BadgePiratesLLC/DefCon_SecKCPartyStar_27/README.md

Party Star 'badge' for the DEFCON 27 SecKC Party.

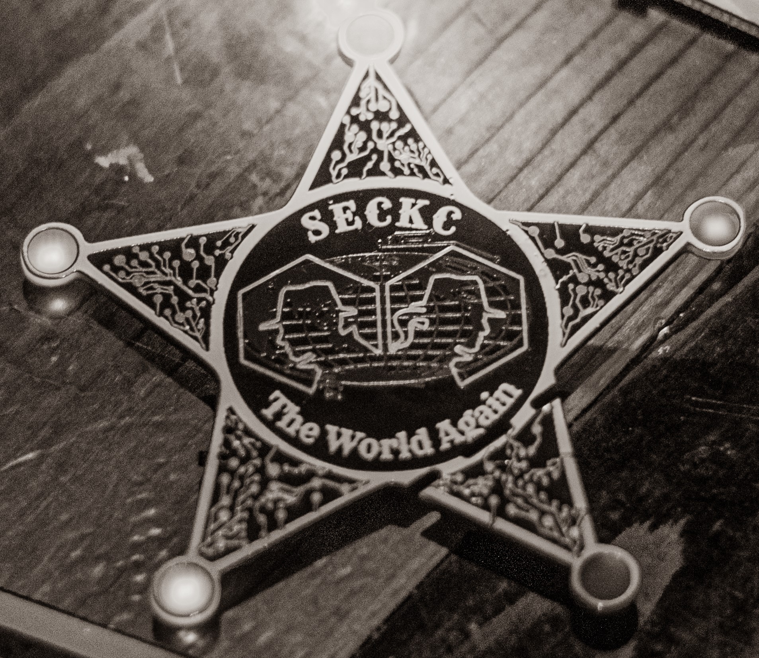
[picture p1: SAO_Twitter_Banner.jpg]
Image of Star
