BadgePiratesLLC/DefCon_SecKCPartyStar_27/Schematics/.svg2shenzhen-cache/images/B.Mask_g828.png

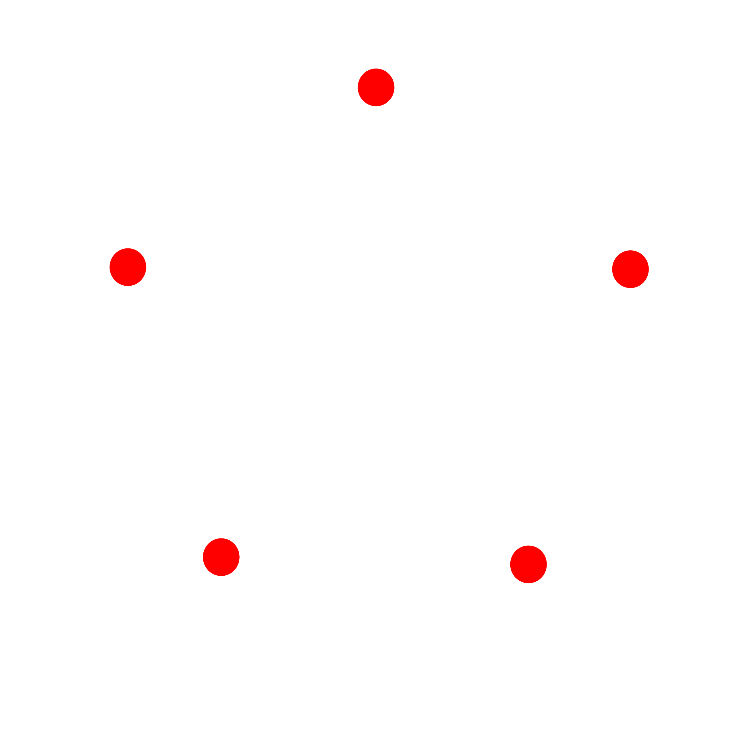
Schematics/.svg2shenzhen-cache/images/B.Mask_g828.png
