BadgePiratesLLC/DefCon_SecKCPartyStar_27/Schematics/.svg2shenzhen-cache/images/F.Cu_g832.png

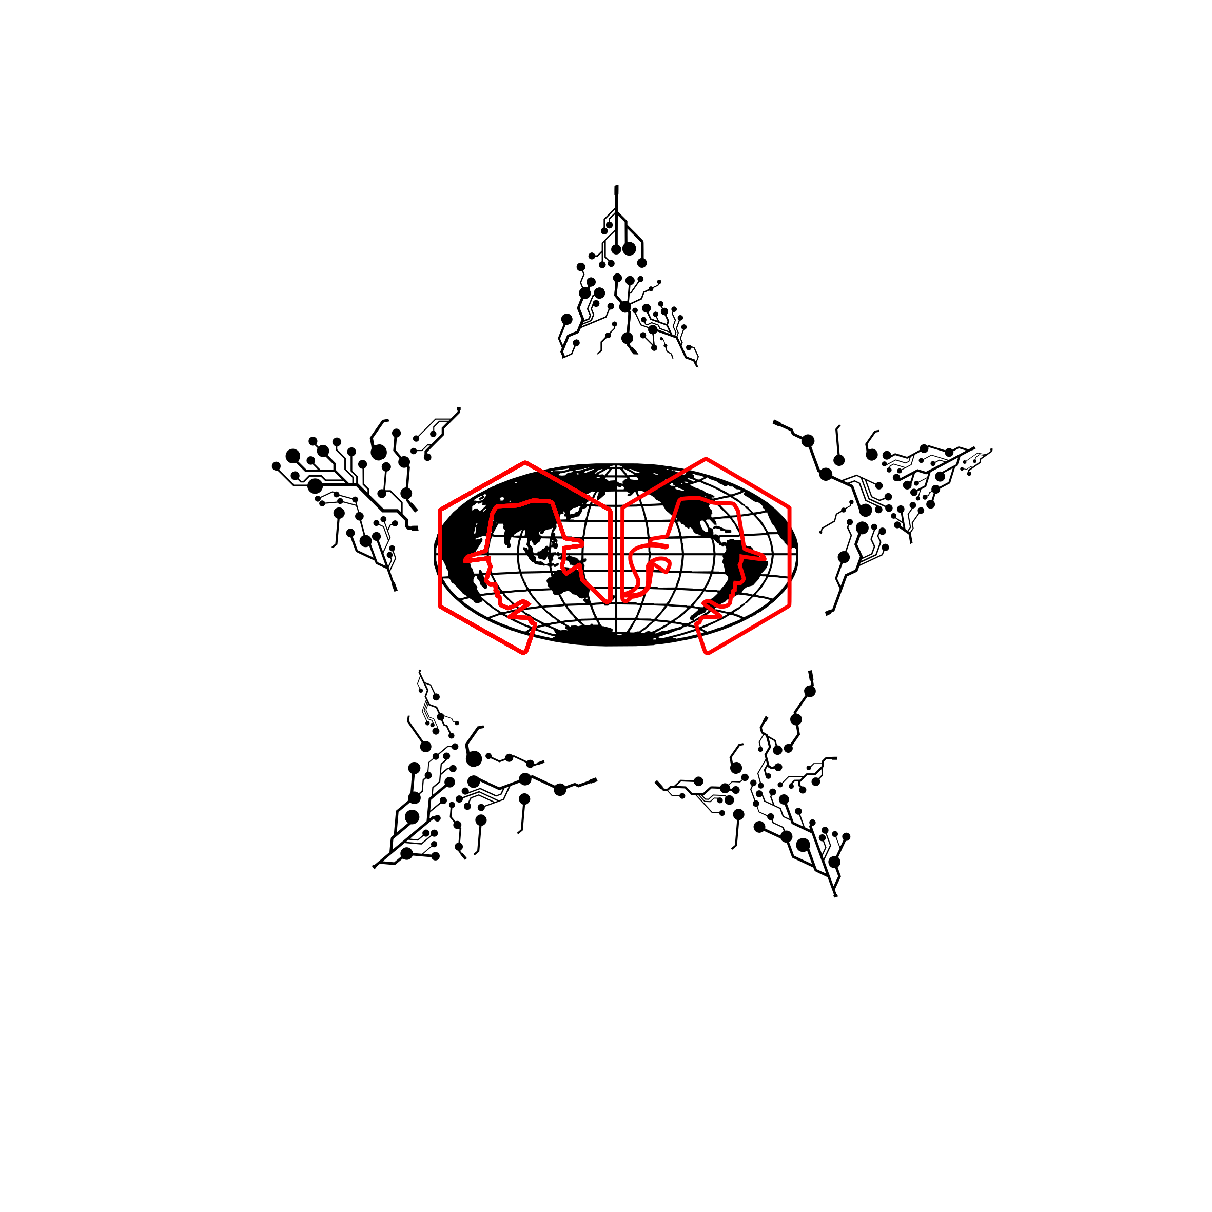
Schematics/.svg2shenzhen-cache/images/F.Cu_g832.png
