BadgePiratesLLC/DefCon_SecKCPartyStar_27/Schematics/.svg2shenzhen-cache/images/F.Mask_g834.png

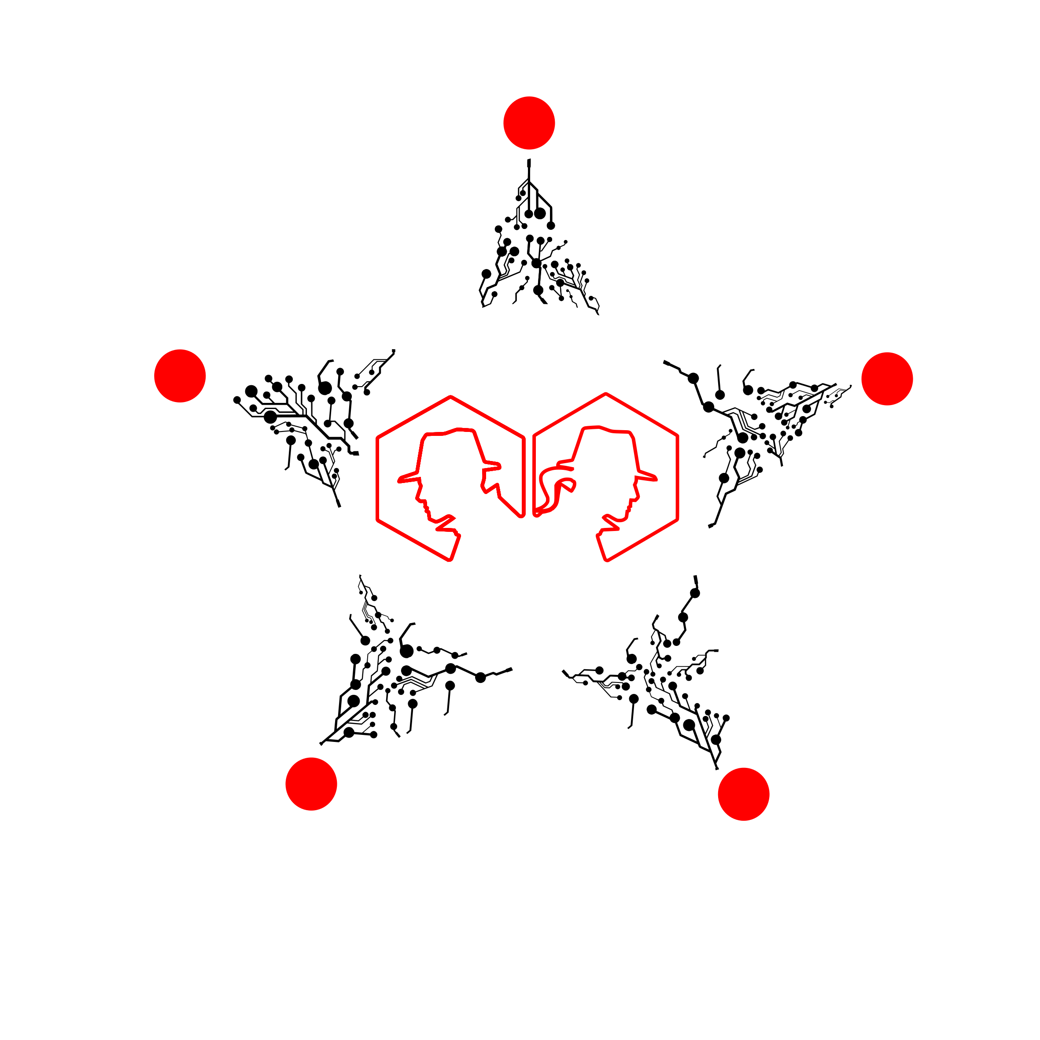
Schematics/.svg2shenzhen-cache/images/F.Mask_g834.png
