BadgePiratesLLC/DefCon_SecKCPartyStar_27/Schematics/.svg2shenzhen-cache/images/F.Silk_g836.png

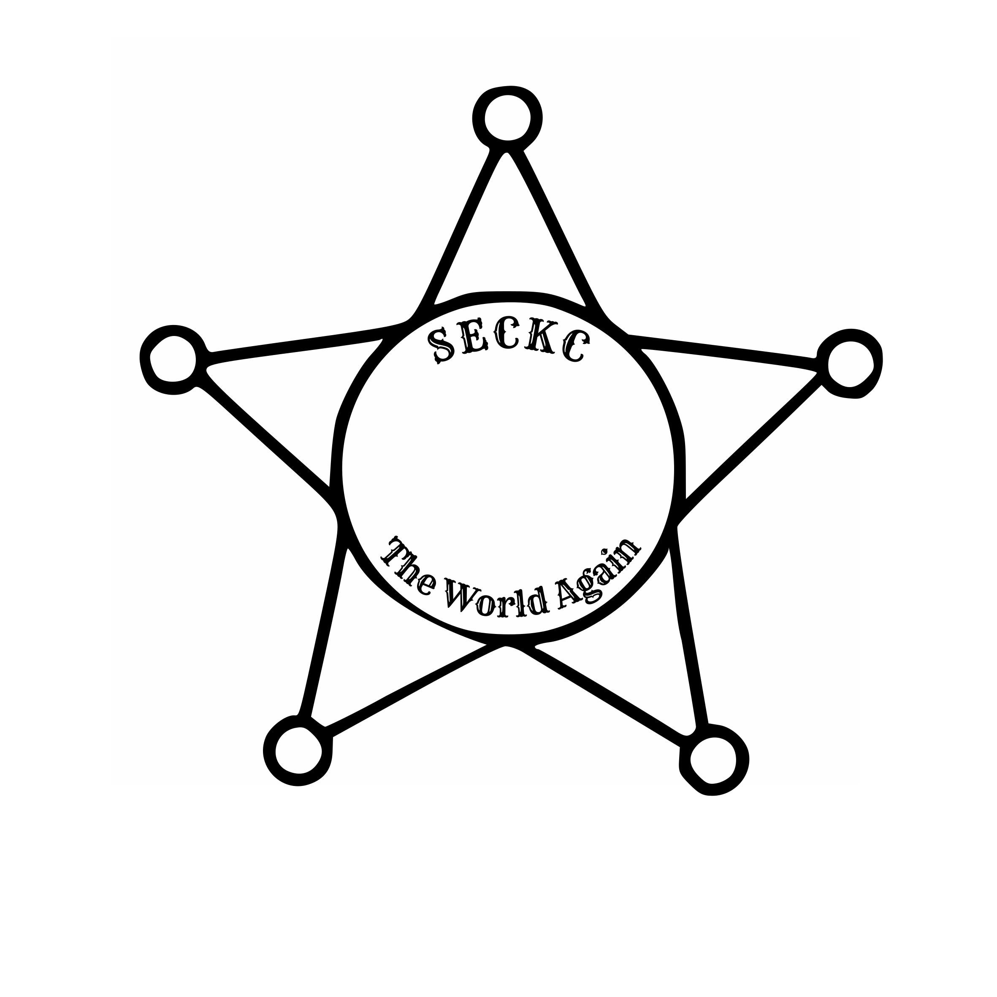
Schematics/.svg2shenzhen-cache/images/F.Silk_g836.png
