BadgePiratesLLC/DefCon_SecKCPartyStar_27/Schematics/PartyStar.xlsx

/home/william/Documents/Projects/BadgePirates/defcon27-seckc_party/Schematics/PartyStar.sch
Fri 28 Jun 2019 12:08:12 PM CDT
Eeschema 5.1.2
Component Count:19
Ref | Qnty | Value | Part | Datasheet | Description | Price each @ 100 |  | Source
BT1 | 1 | Battery_Cell | Device:Battery_Cell | ~ | Single-cell battery |  |  | Beats me
C1, C2 | 2 | 100uF | Device:CP_Small | ~ | Polarized capacitor, small symbol | 0.097 | 0.194 | https://lcsc.com/product-detail/Others_AVX_F930J107MAA_AVX-F930J107MAA_C90056.html
D1, D2, D3, D4 | 4 | LED | Device:LED | ~ | Light emitting diode | 0.0089 | 0.0356 | https://lcsc.com/product-detail/Light-Emitting-Diodes-LED_0805_C205444.html
J1 | 1 | Conn_02x03_Odd_Even | Connector_Generic:Conn_02x03_Odd_Even | ~ | Generic connector, double row, 02x03 | 0.0326 | 0.0326 | https://lcsc.com/product-detail/Pin-Header-Female-Header_Shenzhen-Cankemeng-Headers-Pins-2-3P-2-54mm-SMD_C124390.html
Q1, Q2 | 2 | Q_PNP_BCE | Device:Q_PNP_BCE | ~ | PNP transistor, base/collector/emitter | 0.0121 | 0.0242 | https://lcsc.com/product-detail/MOSFET_Guangdong-Hottech-2N7002_C181082.html
Q3 | 1 | 2N7002 | Transistor_FET:2N7002 | https://www.fairchildsemi.com/datasheets/2N/2N7002.pdf | 0.115A Id, 60V Vds, N-Channel MOSFET, SOT-23 | 0.0118 | 0.0118 | https://lcsc.com/product-detail/MOSFET_SK-2N7002-Silk-screen12W_C111581.html
R1, R2, R5 | 3 | 330 | Device:R_Small | ~ | Resistor, small symbol | 0.0012 | 0.0036 | https://lcsc.com/product-detail/Chip-Resistor-Surface-Mount_330R-331-5_C119075.html
R3, R4 | 2 | 100k | Device:R_Small | ~ | Resistor, small symbol | 0.0012 | 0.0024 | https://lcsc.com/product-detail/New-Arrivals_SANYEAR-SY0805JN100KP_C380778.html
SW1 | 1 | SW_SPDT | Switch:SW_SPDT | ~ | Switch, single pole double throw | 0.0429 | 0.0429 | https://lcsc.com/product-detail/Toggle-Switches_XKB-Enterprise-SK-3296S-01-L1_C319020.html
 |  |  |  |  |  | Total w/o battery | 0.3471
