BadgePiratesLLC/DefCon_SecKCPartyStar_27/(commit log)

2019-06-26 think i got everything working
    [defcon27-seckc-party.kicad_pcb, defcon27-seckc-party.sch]
2019-06-27 final design
    [defcon27-seckc-party.kicad_pcb]
2019-06-27 updated font to Rye and made fonts smaller for both texts
    [defcon27-seckc-party.kicad_pcb]
2019-06-28 Added breakable point
    [PartyStar.kicad_pcb]
2019-06-28 cleaned up the fake traces
    [PartyStar.kicad_pcb]
2019-06-28 added back of board stuff
    [PartyStar.kicad_pcb]
2019-06-28 Ordered V1
    [PartyStar-B_Cu.gbr, PartyStar-B_Mask.gbr, PartyStar-B_SilkS.gbr, PartyStar-Edge_Cuts.gbr, PartyStar-F_Cu.gbr, PartyStar-F_Mask.gbr, PartyStar-F_SilkS.gbr, PartyStar-NPTH.drl]
2019-06-28 Cleaned up traces
    [PartyStar.kicad_pcb]
2019-06-28 More fiddling 2: electric boogaloo
    [PartyStar-B_Cu.gbr, PartyStar-B_Mask.gbr, PartyStar-B_SilkS.gbr, PartyStar-Edge_Cuts.gbr, PartyStar-F_Cu.gbr, PartyStar-F_Mask.gbr, PartyStar-F_SilkS.gbr, PartyStar-NPTH.drl]
2019-06-28 Added bom
    [PartyStar.xlsx]
2019-06-30 fix back solder mask
    [PartyStar.kicad_pcb]
2019-06-30 Fixed SAO header
    [PartyStar.kicad_pcb]
2019-07-04 Added DCP logo
    [PartyStar-B_Cu.gbr, PartyStar-B_Mask.gbr, PartyStar-B_SilkS.gbr, PartyStar-Edge_Cuts.gbr, PartyStar-F_Cu.gbr, PartyStar-F_Mask.gbr, PartyStar-F_SilkS.gbr, PartyStar-NPTH.drl]
2019-07-05 More cleaning, I'll stop now. Bumped to V3
    [PartyStar-B_Cu.gbr, PartyStar-B_Mask.gbr, PartyStar-B_SilkS.gbr, PartyStar-Edge_Cuts.gbr, PartyStar-F_Cu.gbr, PartyStar-F_Mask.gbr, PartyStar-F_SilkS.gbr, PartyStar-NPTH.drl]
2019-07-05 Okay, now I am really done
    [PartyStar-B_Cu.gbr, PartyStar-B_Mask.gbr, PartyStar-B_SilkS.gbr, PartyStar-Edge_Cuts.gbr, PartyStar-F_Cu.gbr, PartyStar-F_Mask.gbr, PartyStar-F_SilkS.gbr, PartyStar-NPTH.drl]
2019-07-10 Changed LEDs, Caps. Bumped to V4
    [PartyStar-B_Cu.gbr, PartyStar-B_Mask.gbr, PartyStar-B_Paste.gbr, PartyStar-B_SilkS.gbr, PartyStar-Edge_Cuts.gbr, PartyStar-F_Cu.gbr, PartyStar-F_Mask.gbr, PartyStar-F_SilkS.gbr]
